wooseongjung/spyderrobot/assets/README.md

# assets/

Static media used by the README and docs.

| Folder | Contents |
|---|---|
| `images/` | Photos of the prototype, board renders, screenshots |
| `diagrams/` | System block diagrams, flowcharts (SVG / PNG) |
