wooseongjung/spyderrobot/firmware/README.md

# firmware/

Embedded C firmware for the custom MCU board.

| Folder | Contents |
|---|---|
| `mcu/` | STM32CubeIDE project: HAL, drivers, application |
| `tests/` | Host-side unit tests with mocked HAL |

Architecture: [`../docs/05-firmware-architecture.md`](../docs/05-firmware-architecture.md)
