wooseongjung/spyderrobot/hardware/enclosure/README.md

# hardware/enclosure/

3D-printed brackets and mounts for the custom PCB and sensors.

Source files: FreeCAD / SolidWorks. Export STLs for printing.

> Empty until the v1 PCB exists and we know what needs mounting.
