wooseongjung/spyderrobot/hardware/pcb/README.md

# hardware/pcb/

KiCad project for the custom STM32 MCU board.

> This folder will be populated in **Phase 3** (see [`../../docs/08-roadmap-milestones.md`](../../docs/08-roadmap-milestones.md)).

Expected layout once populated:

```
pcb/
├── spyder-mcu.kicad_pro
├── spyder-mcu.kicad_sch
├── spyder-mcu.kicad_pcb
├── symbols/                (custom symbol library)
├── footprints/             (custom footprint library)
├── 3d/                     (custom 3D models)
└── gerbers/                (export per fab order)
```

Spec: [`../../docs/04-pcb-design.md`](../../docs/04-pcb-design.md)
Bring-up checklist: [`../../docs/09-test-and-validation.md`](../../docs/09-test-and-validation.md)
