wooseongjung/spyderrobot/hardware/schematics/README.md

# hardware/schematics/

Block diagrams, schematic PDFs, and sub-circuit reference notes.

> Empty until Phase 3. Schematic source-of-truth is the KiCad project in `../pcb/`; this folder is for **exported** PDFs and **standalone block diagrams** that don't belong inside the KiCad project.
