wooseongjung/spyderrobot/assets/diagrams/README.md

# assets/diagrams/

System block diagrams, comms diagrams, power tree, etc.

Source format: prefer SVG (editable, version-controllable) over PNG.

> Empty until ASCII diagrams in `docs/02-system-architecture.md` are upgraded to proper SVGs.
