wooseongjung/spyderrobot/assets/images/README.md

# assets/images/

Photos of the physical prototype, board renders, and dashboard screenshots.

> Empty until Phase 1 produces the first photos.
