wooseongjung/spyderrobot/spider/meshes/ankle_LB_link.STL

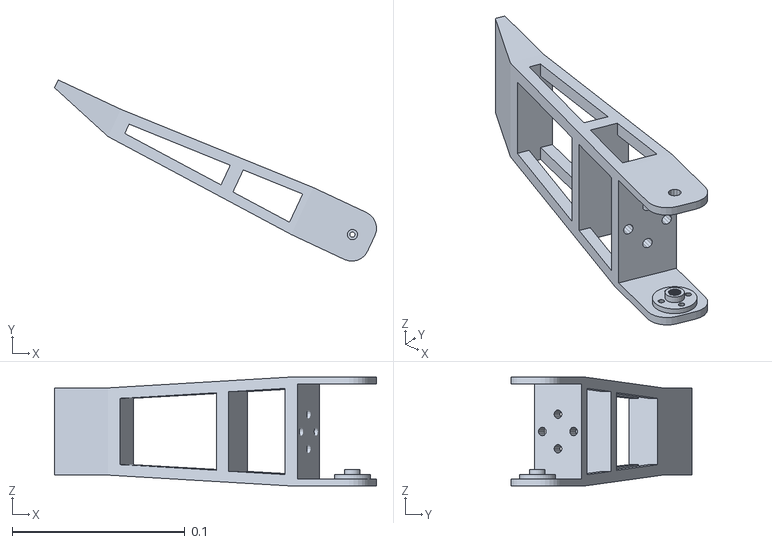
[picture p2: CAD file, 2025-08-24]
spider/meshes/ankle_LB_link.STL
0.186 x 0.105 x 0.063
