wooseongjung/spyderrobot/spider/meshes/knee_RF_link.STL

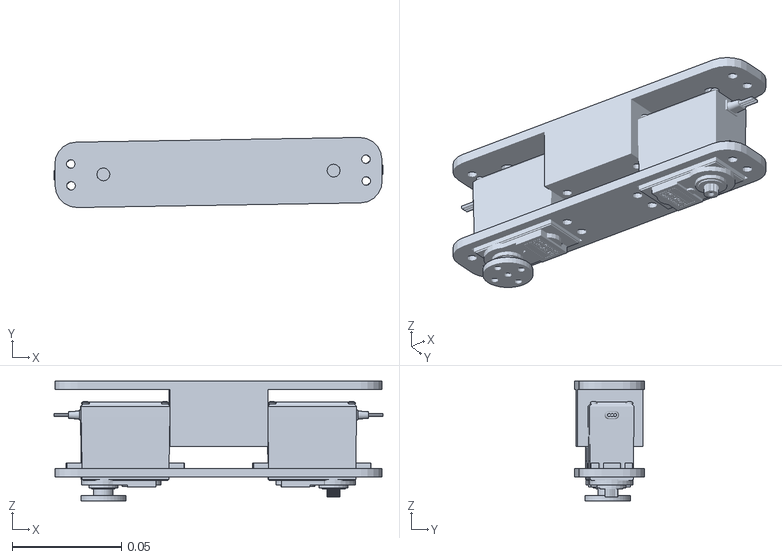
[picture p3: CAD file, 2025-08-24]
spider/meshes/knee_RF_link.STL
0.151 x 0.0321 x 0.055
