wooseongjung/spyderrobot/spider/meshes/hip_RF_link.STL

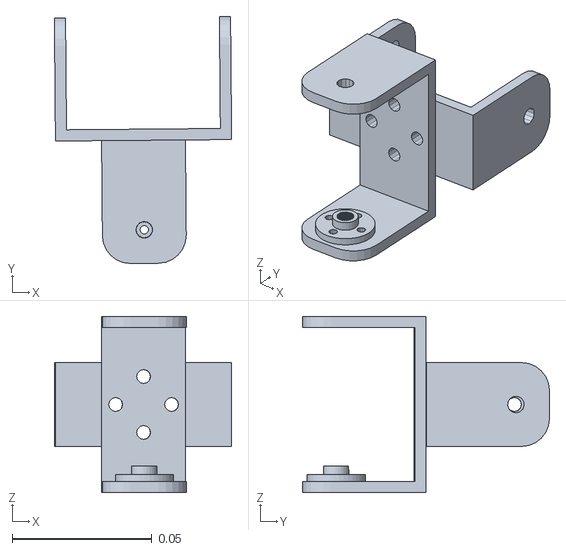
[picture p4: CAD file, 2025-08-24]
spider/meshes/hip_RF_link.STL
0.0634 x 0.0883 x 0.063
