wooseongjung/spyderrobot/spider/meshes/knee_LF_link.STL

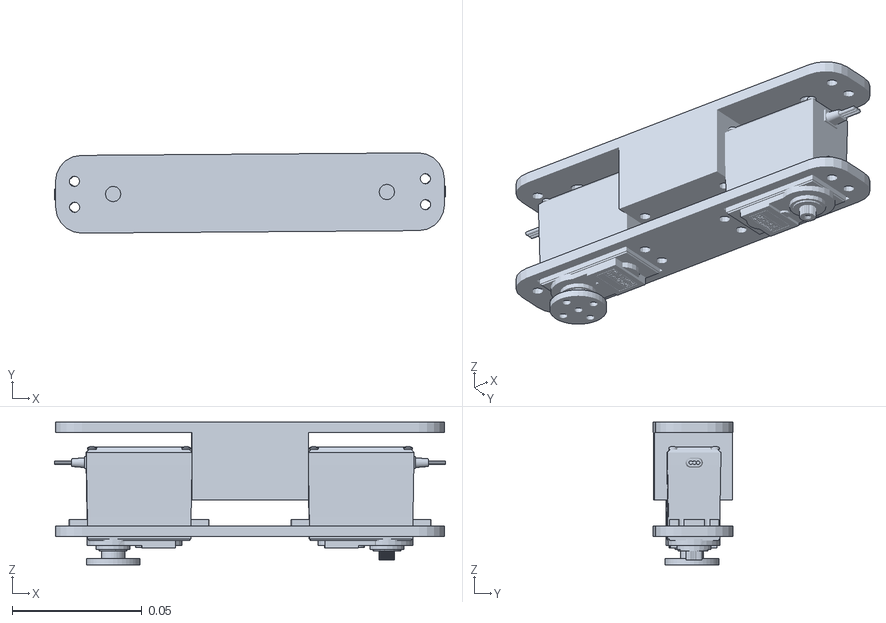
[picture p5: CAD file, 2025-08-24]
spider/meshes/knee_LF_link.STL
0.151 x 0.031 x 0.055
