wooseongjung/spyderrobot/spider/meshes/hip_LB_link.STL

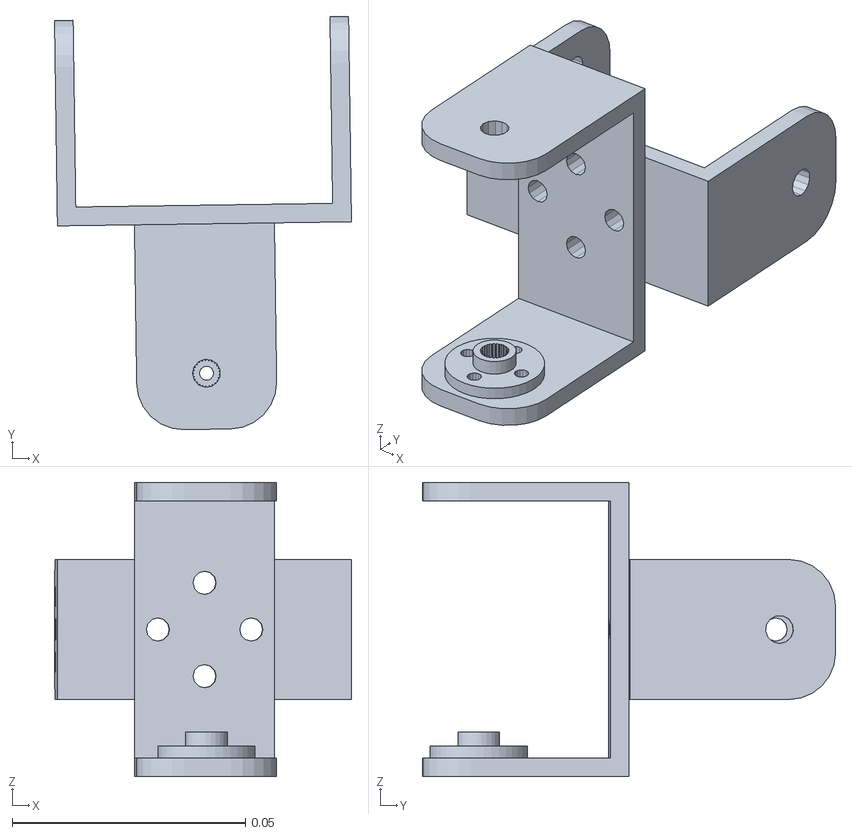
[picture p6: CAD file, 2025-08-24]
spider/meshes/hip_LB_link.STL
0.0636 x 0.0885 x 0.063
