wooseongjung/spyderrobot/spider/meshes/ankle_RB_link.STL

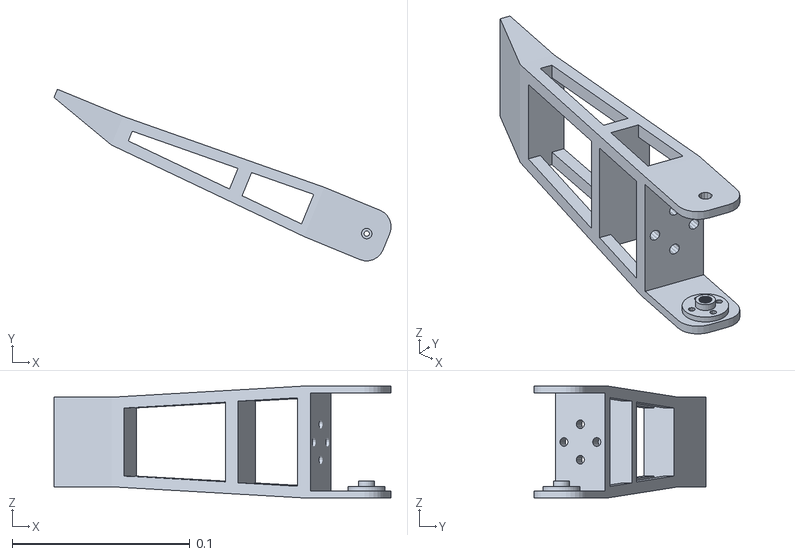
[picture p7: CAD file, 2025-08-24]
spider/meshes/ankle_RB_link.STL
0.19 x 0.0966 x 0.063
