wooseongjung/spyderrobot/spider/meshes/ankle_LF_link.STL

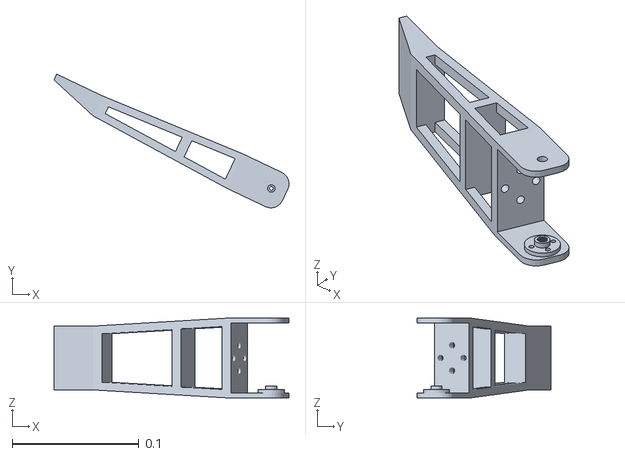
[picture p8: CAD file, 2025-08-24]
spider/meshes/ankle_LF_link.STL
0.186 x 0.106 x 0.063
