wooseongjung/spyderrobot/spider/meshes/base_link.STL

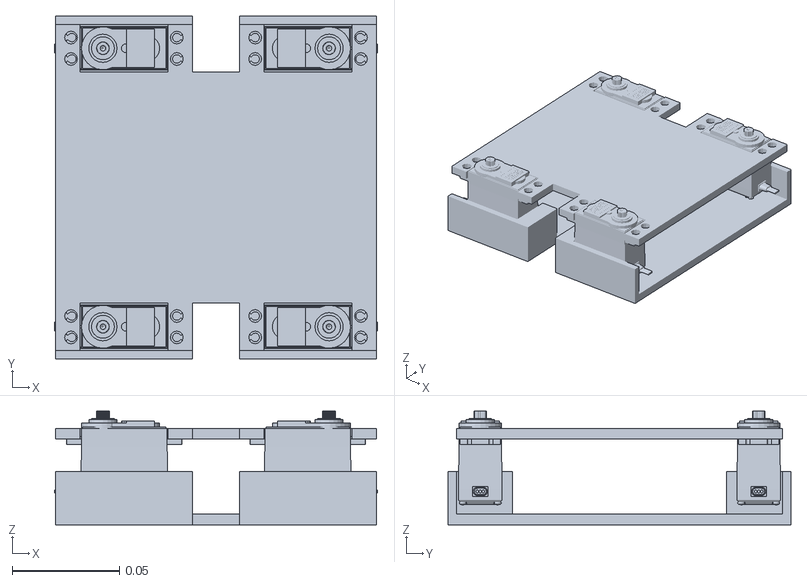
[picture p9: CAD file, 2025-08-24]
spider/meshes/base_link.STL
0.151 x 0.16 x 0.0531
