wooseongjung/spyderrobot/(list of files, cad)

Other CAD files:
spider/meshes/knee_RB_link.STL
spider/meshes/hip_RB_link.STL
spider/meshes/ankle_RF_link.STL
spider/meshes/hip_LF_link.STL
spider/meshes/knee_LB_link.STL
