wooseongjung/spyderrobot/hardware/pcb/spyder-mcu-v1/spyder-mcu-v1.kicad_sch

## KiCad design hardware/pcb/spyder-mcu-v1/spyder-mcu-v1.kicad_sch (2026-04-12)

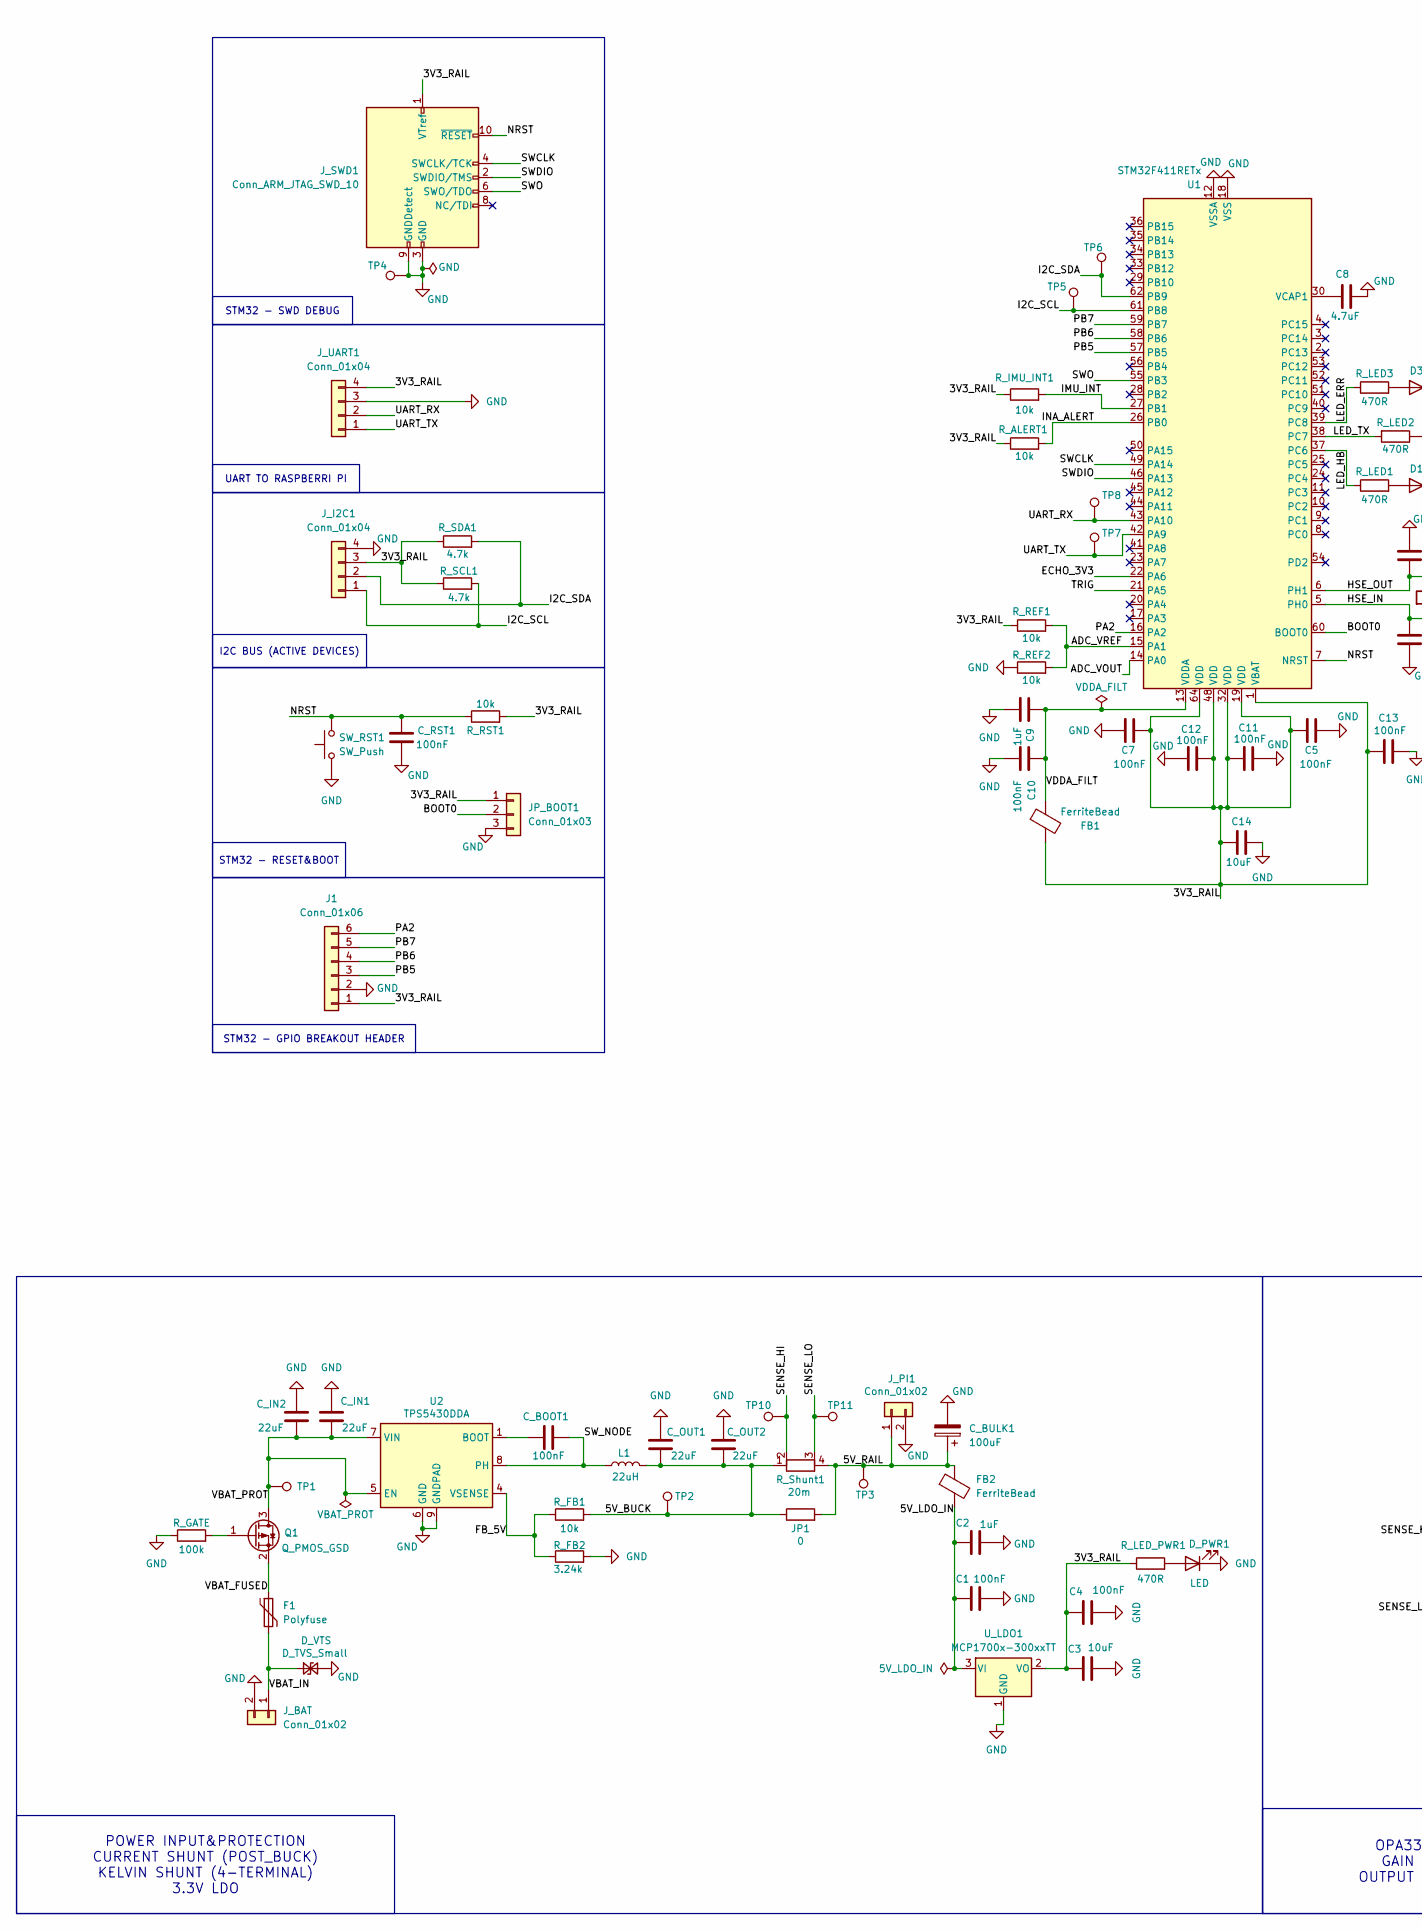
[picture p10: schematic spyder-mcu-v1.kicad_sch, part in row 1, column 1]

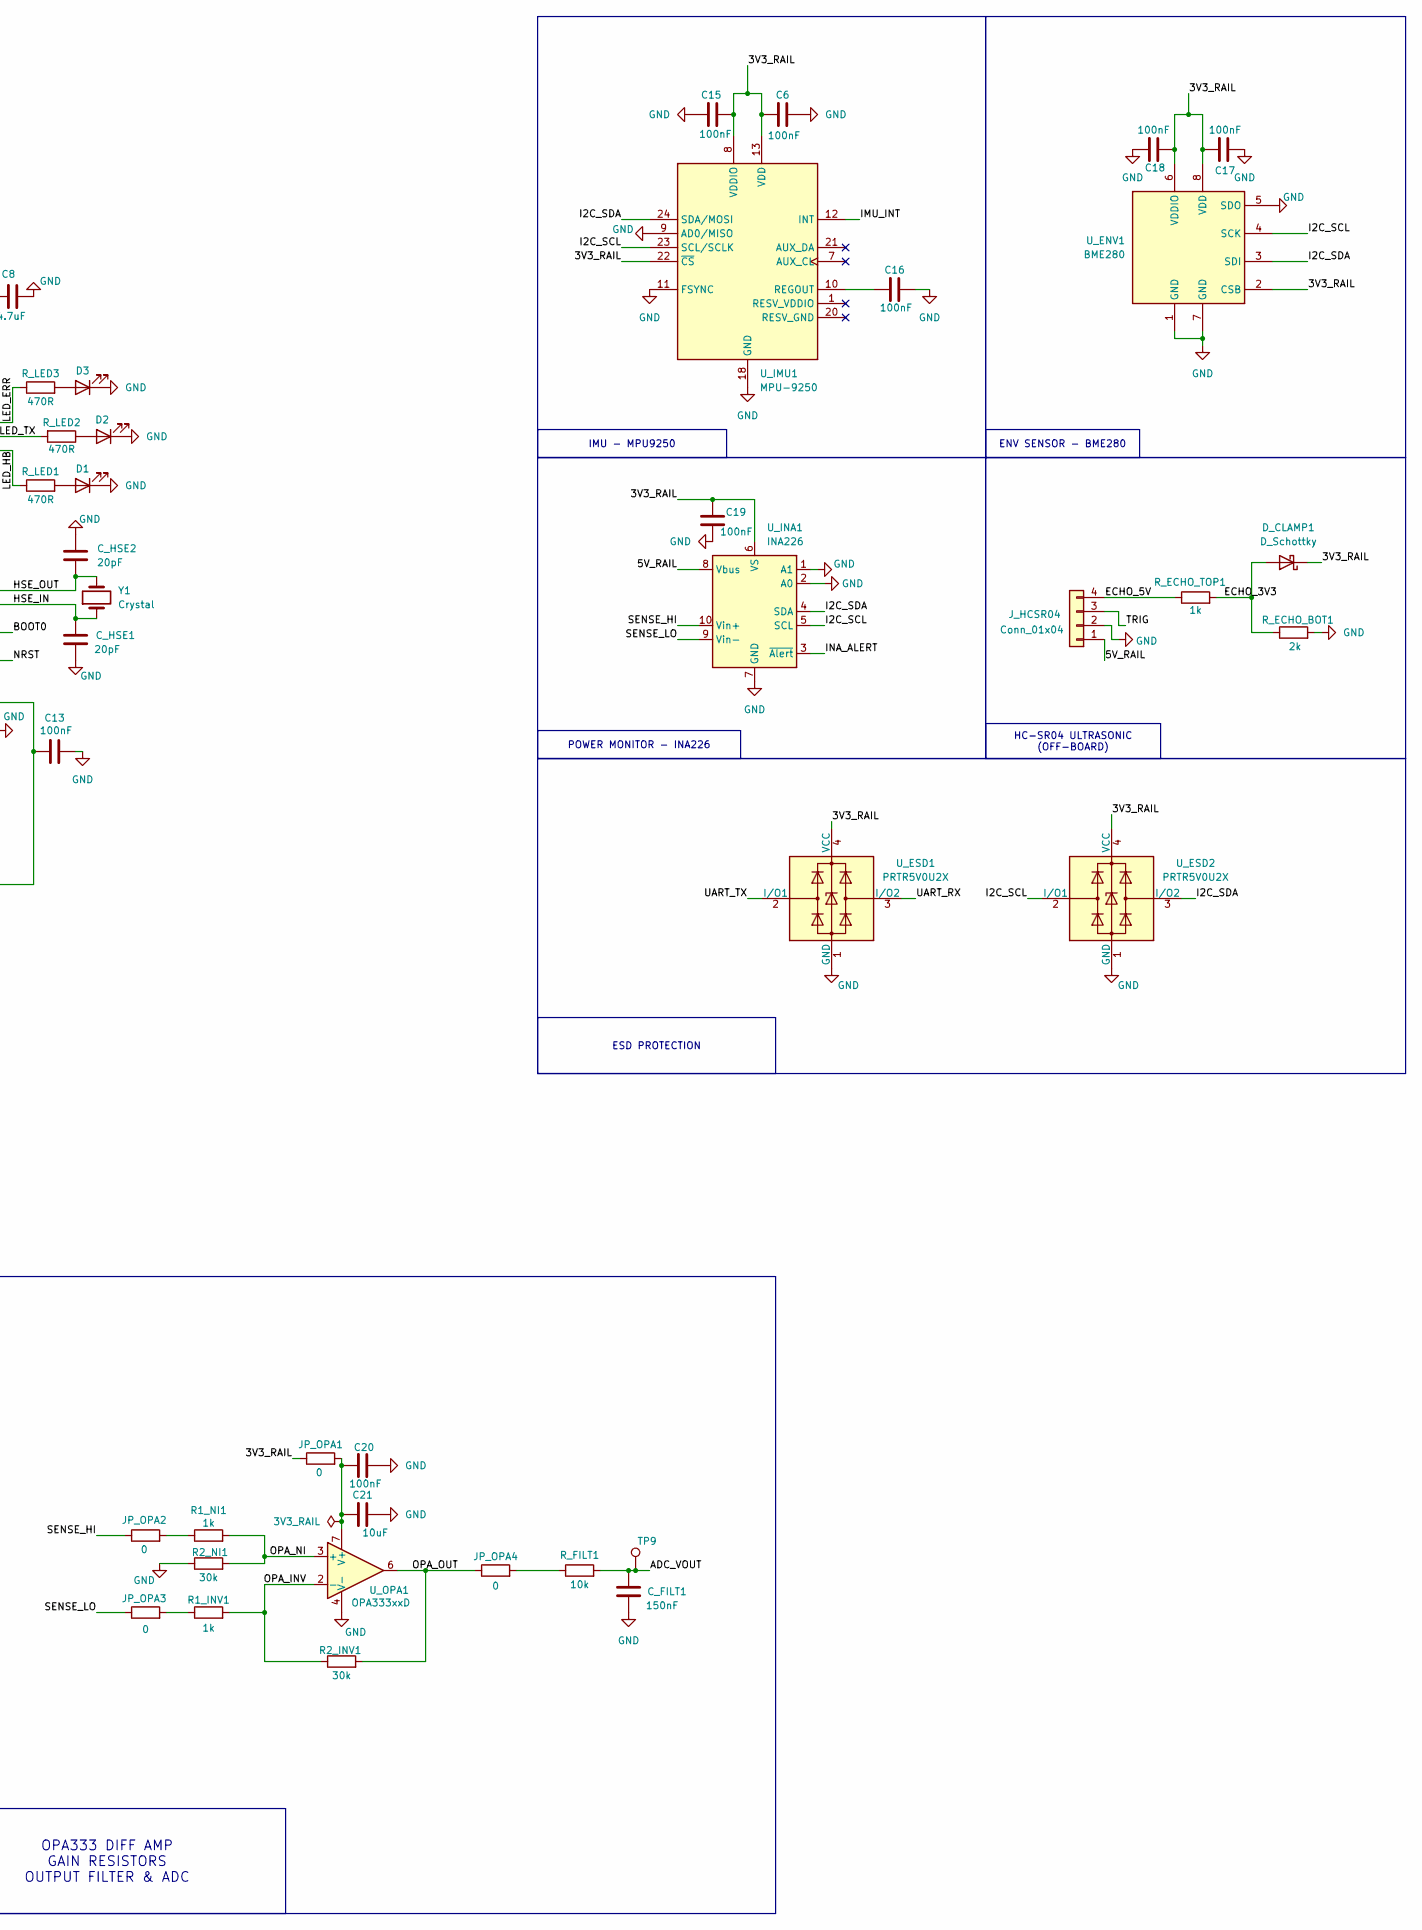
[picture p11: schematic spyder-mcu-v1.kicad_sch, part in row 1, column 2]

Parts:
C1, C4, C5, C6, C7, C10, C11, C12, C13, C15, C16, C17, C18, C19, C20: 100nF
C2, C9: 1uF
C3, C14, C21: 10uF
C8: 4.7uF
C_BOOT1: 100nF
C_BULK1: 100uF
C_FILT1: 150nF
C_HSE1, C_HSE2: 20pF; C_0805_2012Metric_Pad1.18x1.45mm_HandSolder
C_IN1, C_IN2: 22uF
C_OUT1, C_OUT2: 22uF
C_RST1: 100nF
D1, D2, D3: LED
D_CLAMP1: D_Schottky
D_PWR1: LED
D_VTS: D_TVS_Small
F1: Polyfuse
FB1, FB2: FerriteBead
J1: Conn_01x06
JP1: 0
JP_BOOT1: Conn_01x03
JP_OPA1, JP_OPA2, JP_OPA3, JP_OPA4: 0
J_BAT: Conn_01x02
J_HCSR04: Conn_01x04
J_I2C1: Conn_01x04
J_PI1: Conn_01x02
J_SWD1: Conn_ARM_JTAG_SWD_10
J_UART1: Conn_01x04
L1: 22uH
Q1: Q_PMOS_GSD
R1_INV1, R1_NI1: 1k
R2_INV1, R2_NI1: 30k
R_ALERT1: 10k
R_ECHO_BOT1: 2k
R_ECHO_TOP1: 1k
R_FB1: 10k
R_FB2: 3.24k
R_FILT1: 10k
R_GATE: 100k
R_IMU_INT1: 10k
R_LED1, R_LED2, R_LED3: 470R
R_LED_PWR1: 470R
R_REF1, R_REF2: 10k
R_RST1: 10k
R_SCL1: 4.7k
R_SDA1: 4.7k
R_Shunt1: 20m
SW_RST1: SW_Push
TP1, TP2, TP3, TP4, TP5, TP6, TP7, TP8, TP9, TP10, TP11: TestPoint
U1: STM32F411RETx; LQFP-64_10x10mm_P0.5mm
U2: TPS5430DDA; TI_SO-PowerPAD-8_ThermalVias
U_ENV1: BME280; Bosch_LGA-8_2.5x2.5mm_P0.65mm_ClockwisePinNumbering
U_ESD1, U_ESD2: PRTR5V0U2X; SOT-143
U_IMU1: MPU-9250; InvenSense_QFN-24_3x3mm_P0.4mm
U_INA1: INA226; TSSOP-10_3x3mm_P0.5mm
U_LDO1: MCP1700x-300xxTT; SOT-23
U_OPA1: OPA333xxD; SOIC-8_3.9x4.9mm_P1.27mm
Y1: Crystal; Crystal_SMD_HC49-SD_HandSoldering

Connections:
3V3_RAIL: C3.1, C4.1, C5.2, C6.1, C7.1, C11.2, C12.2, C13.1, C14.1, C15.2, C17.1, C18.2, C19.1, D_CLAMP1.1 (K), FB1.2, J1.1, JP_BOOT1.1, JP_OPA1.1, J_I2C1.3, J_SWD1.1 (VTref), J_UART1.4, R_ALERT1.1, R_IMU_INT1.1, R_LED_PWR1.1, R_REF1.1, R_RST1.2, R_SCL1.1, R_SDA1.1, U1.1 (VBAT), U1.19 (VDD), U1.32 (VDD), U1.48 (VDD), U1.64 (VDD), U_ENV1.2 (CSB), U_ENV1.6 (VDDIO), U_ENV1.8 (VDD), U_ESD1.4 (VCC), U_ESD2.4 (VCC), U_IMU1.8 (VDDIO), U_IMU1.13 (VDD), U_IMU1.22 (~CS), U_INA1.6 (VS), U_LDO1.2 (VO)
5V_BUCK: C_OUT1.2, C_OUT2.2, JP1.1, L1.2, R_FB1.2, R_Shunt1.1, TP2.1
5V_LDO_IN: C1.1, C2.1, FB2.2, U_LDO1.3 (VI)
5V_RAIL: C_BULK1.1, FB2.1, JP1.2, J_HCSR04.1, J_PI1.1, R_Shunt1.4, TP3.1, U_INA1.8 (Vbus)
ADC_VOUT: C_FILT1.1, R_FILT1.2, TP9.1, U1.14 (PA0)
ADC_VREF: R_REF1.2, R_REF2.2, U1.15 (PA1)
BOOT0: JP_BOOT1.2, U1.60 (BOOT0)
ECHO_3V3: D_CLAMP1.2 (A), R_ECHO_BOT1.1, R_ECHO_TOP1.2, U1.22 (PA6)
ECHO_5V: J_HCSR04.4, R_ECHO_TOP1.1
FB_5V: R_FB1.1, R_FB2.1, U2.4 (VSENSE)
GND: C1.2, C2.2, C3.2, C4.2, C5.1, C6.2, C7.2, C8.2, C9.2, C10.2, C11.1, C12.1, C13.2, C14.2, C15.1, C16.2, C17.2, C18.1, C19.2, C20.2, C21.2, C_BULK1.2, C_FILT1.2, C_HSE1.2, C_HSE2.1, C_IN1.1, C_IN2.1, C_OUT1.1, C_OUT2.1, C_RST1.2, D1.1 (K), D2.1 (K), D3.1 (K), D_PWR1.1 (K), D_VTS.2 (A2), J1.2, JP_BOOT1.3, J_BAT.2, J_HCSR04.2, J_I2C1.4, J_PI1.2, J_SWD1.3 (GND), J_SWD1.5 (GND), J_SWD1.9 (GNDDetect), J_UART1.3, R2_NI1.1, R_ECHO_BOT1.2, R_FB2.2, R_GATE.1, R_REF2.1, SW_RST1.1, TP4.1, U1.12 (VSSA), U1.18 (VSS), U1.31 (VSS), U1.47 (VSS), U1.63 (VSS), U2.6 (GND), U2.9 (GNDPAD), U_ENV1.1 (GND), U_ENV1.5 (SDO), U_ENV1.7 (GND), U_ESD1.1 (GND), U_ESD2.1 (GND), U_IMU1.9 (AD0/MISO), U_IMU1.11 (FSYNC), U_IMU1.18 (GND), U_INA1.1 (A1), U_INA1.2 (A0), U_INA1.7 (GND), U_LDO1.1 (GND), U_OPA1.4 (V-)
HSE_IN: C_HSE1.1, U1.5 (PH0), Y1.1
HSE_OUT: C_HSE2.2, U1.6 (PH1), Y1.2
I2C_SCL: J_I2C1.1, R_SCL1.2, TP5.1, U1.61 (PB8), U_ENV1.4 (SCK), U_ESD2.2 (I/O1), U_IMU1.23 (SCL/SCLK), U_INA1.5 (SCL)
I2C_SDA: J_I2C1.2, R_SDA1.2, TP6.1, U1.62 (PB9), U_ENV1.3 (SDI), U_ESD2.3 (I/O2), U_IMU1.24 (SDA/MOSI), U_INA1.4 (SDA)
IMU_INT: R_IMU_INT1.2, U1.27 (PB1), U_IMU1.12 (INT)
INA_ALERT: R_ALERT1.2, U1.26 (PB0), U_INA1.3 (~Alert)
LED_ERR: R_LED3.1, U1.39 (PC8)
LED_HB: R_LED1.1, U1.37 (PC6)
LED_TX: R_LED2.2, U1.38 (PC7)
NRST: C_RST1.1, J_SWD1.10 (~RESET), R_RST1.1, SW_RST1.2, U1.7 (NRST)
unnamed: C8.1, U1.30 (VCAP1)
unnamed: C16.1, U_IMU1.10 (REGOUT)
unnamed: C20.1, C21.1, JP_OPA1.2, U_OPA1.7 (V+)
unnamed: C_BOOT1.1, U2.1 (BOOT)
unnamed: D1.2 (A), R_LED1.2
unnamed: D2.2 (A), R_LED2.1
unnamed: D3.2 (A), R_LED3.2
unnamed: D_PWR1.2 (A), R_LED_PWR1.2
unnamed: JP_OPA2.2, R1_NI1.1
unnamed: JP_OPA3.2, R1_INV1.1
unnamed: JP_OPA4.2, R_FILT1.1
unnamed: Q1.1 (G), R_GATE.2
OPA_INV: R1_INV1.2, R2_INV1.1, U_OPA1.2 (-)
OPA_NI: R1_NI1.2, R2_NI1.2, U_OPA1.3 (+)
OPA_OUT: JP_OPA4.1, R2_INV1.2, U_OPA1.6
PA2: J1.6, U1.16 (PA2)
PB5: J1.3, U1.57 (PB5)
PB6: J1.4, U1.58 (PB6)
PB7: J1.5, U1.59 (PB7)
SENSE_HI: JP_OPA2.1, R_Shunt1.2, TP10.1, U_INA1.10 (Vin+)
SENSE_LO: JP_OPA3.1, R_Shunt1.3, TP11.1, U_INA1.9 (Vin-)
SWCLK: J_SWD1.4 (SWCLK/TCK), U1.49 (PA14)
SWDIO: J_SWD1.2 (SWDIO/TMS), U1.46 (PA13)
SWO: J_SWD1.6 (SWO/TDO), U1.55 (PB3)
SW_NODE: C_BOOT1.2, L1.1, U2.8 (PH)
TRIG: J_HCSR04.3, U1.21 (PA5)
UART_RX: J_UART1.2, TP8.1, U1.43 (PA10), U_ESD1.3 (I/O2)
UART_TX: J_UART1.1, TP7.1, U1.42 (PA9), U_ESD1.2 (I/O1)
VBAT_FUSED: F1.1, Q1.2 (S)
VBAT_IN: D_VTS.1 (A1), F1.2, J_BAT.1
VBAT_PROT: C_IN1.2, C_IN2.2, Q1.3 (D), TP1.1, U2.5 (EN), U2.7 (VIN)
VDDA_FILT: C9.1, C10.1, FB1.1, U1.13 (VDDA)

Notes on the sheet:
HC-SR04 ULTRASONIC (OFF-BOARD)
OPA333 DIFF AMP GAIN RESISTORS OUTPUT FILTER & ADC
STM32 - SWD DEBUG
ENV SENSOR - BME280
UART TO RASPBERRI PI
STM32 - RESET&BOOT
I2C BUS (ACTIVE DEVICES)
POWER MONITOR - INA226
IMU - MPU9250
ESD PROTECTION
POWER INPUT&PROTECTION CURRENT SHUNT (POST_BUCK) KELVIN SHUNT (4-TERMINAL) 3.3V LDO
STM32 - GPIO BREAKOUT HEADER
