wooseongjung/spyderrobot/pi/telemetry/logger.py

"""Phase 1 telemetry logger.

Polls every sensor at the rate set in config.yaml, writes one CSV row
per cycle, prints a one-line status to stdout, and (optionally) updates
the OLED display.

Run on the Pi:
    cd ~/spyderrobot/pi/telemetry
    python -m logger

Stop with Ctrl-C; the CSV file is closed cleanly.
"""

from __future__ import annotations

import csv
import signal
import sys
import time
from dataclasses import asdict
from datetime import datetime, timezone
from pathlib import Path

import yaml

from display import OledDisplay
from sensors.dht11 import DHT11
from sensors.hcsr04 import HCSR04
from sensors.mpu6050 import MPU6050


CONFIG_PATH = Path(__file__).parent / "config.yaml"


def load_config() -> dict:
    with open(CONFIG_PATH) as f:
        return yaml.safe_load(f)


def open_csv(path: Path) -> tuple:
    """Open the output CSV and write the header row."""
    path.parent.mkdir(parents=True, exist_ok=True)
    f = open(path, "w", newline="")
    writer = csv.writer(f)
    writer.writerow([
        "iso_ts", "t_ms",
        "ax_g", "ay_g", "az_g",
        "gx_dps", "gy_dps", "gz_dps",
        "imu_temp_c",
        "env_temp_c", "env_rh",
        "dist_mm",
        "errors_imu", "errors_env", "errors_dist",
    ])
    return f, writer


def main() -> int:
    cfg = load_config()
    period_s = 1.0 / cfg.get("rate_hz", 5)
    out_path = Path(cfg.get("output_csv", "sample_data/run.csv"))
    sensor_cfg = cfg.get("sensors", {})

    imu  = MPU6050()  if sensor_cfg.get("imu",      {}).get("enabled", True) else None
    env  = DHT11()    if sensor_cfg.get("env",      {}).get("enabled", True) else None
    dist = HCSR04()   if sensor_cfg.get("distance", {}).get("enabled", True) else None

    display_cfg = cfg.get("display", {})
    display = (
        OledDisplay(address=int(display_cfg.get("i2c_address", 0x3C)))
        if display_cfg.get("enabled", False)
        else None
    )

    for s in (imu, env, dist, display):
        if s is None:
            continue
        try:
            s.open()
        except NotImplementedError as e:
            print(f"[skip] {type(s).__name__}: {e}", file=sys.stderr)

    t0 = time.monotonic()
    f, writer = open_csv(out_path)

    stopping = False
    def _stop(_signum, _frame):
        nonlocal stopping
        stopping = True
    signal.signal(signal.SIGINT, _stop)
    signal.signal(signal.SIGTERM, _stop)

    try:
        while not stopping:
            cycle_start = time.monotonic()
            t_ms = int((cycle_start - t0) * 1000)
            iso_ts = datetime.now(timezone.utc).isoformat(timespec="milliseconds")

            imu_r  = _safe_read(imu)  if imu  else None
            env_r  = _safe_read(env)  if env  else None
            dist_r = _safe_read(dist) if dist else None

            row = [
                iso_ts, t_ms,
                *(imu_r.accel_g if imu_r else (None, None, None)),
                *(imu_r.gyro_dps if imu_r else (None, None, None)),
                imu_r.temp_c if imu_r else None,
                env_r.temp_c if env_r else None,
                env_r.rh if env_r else None,
                dist_r.distance_mm if dist_r else None,
                imu.error_count  if imu  else 0,
                env.error_count  if env  else 0,
                dist.error_count if dist else 0,
            ]
            writer.writerow(row)
            f.flush()

            print(f"[{iso_ts}] env={row[9]}C/{row[10]}% ax={row[2]} ay={row[3]} az={row[4]}")

            if display is not None:
                try:
                    display.show({
                        "ax": row[2], "ay": row[3], "az": row[4],
                        "temp_c": row[9], "rh": row[10],
                    })
                except Exception as e:
                    print(f"[display] {e}", file=sys.stderr)

            sleep_s = period_s - (time.monotonic() - cycle_start)
            if sleep_s > 0:
                time.sleep(sleep_s)
    finally:
        f.close()
        for s in (imu, env, dist, display):
            if s is None:
                continue
            try:
                s.close()
            except Exception:
                pass

    return 0


def _safe_read(sensor):
    """Call .read() and swallow NotImplementedError so the logger can run
    even when only some drivers are wired up. Real exceptions still pass
    through."""
    try:
        return sensor.read()
    except NotImplementedError:
        return None


if __name__ == "__main__":
    raise SystemExit(main())
