wooseongjung/spyderrobot/(commit log)

2025-08-22 spyderURDF
    prototype version of spyder robot is designed through Solidworks and exported in URDF file with meshes
    [ankle_LB_link.STL, ankle_LF_link.STL, ankle_RB_link.STL, ankle_RF_link.STL, base_link.STL, hip_LB_link.STL, hip_LF_link.STL, hip_RB_link.STL]
2025-08-24 Updated version of URDF for spyder robot
    Added motors, and bottom plate as an entity since when simulated the previous URDF to SDF converted file, it collapsed immediately as I start simulating. I thought this might be because of not fully defining the object which led to having spaces between parts and immediately collapse.
    [ankle_LB_link.STL, ankle_LF_link.STL, ankle_RB_link.STL, ankle_RF_link.STL, base_link.STL, hip_LB_link.STL, hip_LF_link.STL, hip_RB_link.STL]
2026-04-09 chore: add MIT LICENSE and .gitignore
    Adds an MIT license and a .gitignore covering KiCad, STM32CubeIDE,
    PlatformIO, Python, and ROS build artefacts. Preserves spider/export.log
    since it ships with the existing ROS package.
2026-04-09 docs: rewrite README to frame project as sensing platform
    Reframes spyderrobot from "12-servo quadruped that performs spider
    motion" to "sensorised quadruped platform for remote environmental
    awareness and robot-state monitoring." The original 1-line description
    is preserved verbatim as a blockquote near the top.
    The new README adds:
    - project status table tied to phased milestones
    - Option A system architecture diagram (Pi 5 + custom MCU board +
    external PCA9685)
    - repo layout pointing at the new docs/ and scaffold folders
    - skills demonstrated section aimed at recruiters
    - prototype vs target-v2 hardware table
    - index of all docs/01..12 files
    The existing spider/ ROS package is referen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
2026-04-09 docs: add docs/ folder with engineering documentation outlines
    Adds 12 documentation files as structured outlines with TODO markers
    for technical details that will be filled in as the project progresses.
    01-project-overview.md problem statement, scope, what it is NOT
    02-system-architecture.md block diagram, comms, power tree
    03-hardware-bom.md prototype vs target-v2 BOM
    04-pcb-design.md custom STM32 board spec, functional blocks
    05-firmware-architecture.md STM32 layered design, scheduler, UART frame
    06-pi-software.md Pi 5 telemetry, dashboard, camera, UI
    07-mechanical-simulation.md cross-references the existing spider/ ROS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
2026-04-09 chore: add scaffold folders for hardware, firmware, pi, assets
    Adds empty scaffold folders so future commits in each phase land in
    the right place. Each folder ships with a small README explaining what
    belongs there and which phase will populate it.
    hardware/pcb/ KiCad project (Phase 3)
    hardware/schematics/ exported schematic PDFs and standalone block diagrams
    hardware/enclosure/ 3D-printed mounts (post-PCB)
    firmware/mcu/ STM32CubeIDE project (Phase 2)
    firmware/tests/ host-side unit tests
    pi/telemetry/ UART parser, CSV logger, dashboard (Phases 1-2)
    pi/camera/ Pi AI Camera capture (Phase 5)
    pi/interface/ operator UI, joysti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
2026-04-09 feat(pi): scaffold Phase 1 telemetry stack on Pi 5
    Adds runnable Python skeletons for the Phase 1 breadboard prototype:
    read every prototype sensor directly from the Pi 5, log to CSV, and
    (optionally) push to the OLED. Phase 2 will replace the per-sensor
    reads with a UART parser for the custom MCU board, but the Phase 1
    loop is what proves each sensor works.
    pi/telemetry/sensors/mpu6050.py I2C IMU driver skeleton
    pi/telemetry/sensors/dht11.py 1-wire temp/humidity skeleton
    pi/telemetry/sensors/hcsr04.py ultrasonic distance skeleton
    pi/telemetry/sensors/raindrop.py digital wetness skeleton
    pi/telemetry/display.py SSD1306 OLED skeleton
    pi/telemetry/logger.py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
    [config.yaml, dht11.py, display.py, hcsr04.py, logger.py, mpu6050.py]
2026-04-09 docs(phase1): add wiring cheat sheet, narrow scope to IMU + DHT11 + OLED
    Phase 1 is now MPU6050 + DHT11 + SSD1306 OLED only. The HC-SR04 and
    raindrop sensors are deferred to Phase 2 (STM32), where the level
    shifting and analog ADC concerns are handled natively. Their driver
    scaffolds in pi/telemetry/sensors/ are kept but disabled in config.yaml.
    docs/phase1-wiring.md new: step-by-step wiring cheat sheet
    with Pi 5 pin map, i2cdetect verification,
    3-pin vs 4-pin DHT11 variants, sanity
    checks before power-on, troubleshooting
    table, and first-light test seque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
2026-04-09 docs(phase1): add NI myDAQ sidebar to wiring cheat sheet
    Adds a section on using the NI myDAQ as the bench instrument during
    Phase 1 bring-up, covering:
    - DMM continuity + rail checks before powering anything
    - Scope probing SDA/SCL when i2cdetect fails or shows ghost addresses,
    with a short diagnosis table for the common waveforms (no activity,
    stuck line, slow edges, garbled)
    - Using the myDAQ +5 V supply to bench-test a sensor module without
    risking the Pi
    No scope change to Phase 1 - the two deferred sensors stay deferred.
2026-04-09 docs: add CLAUDE.md for cross-session project instructions
    Bootstraps every Claude Code session opening this repo with:
    - the project's re-scoped framing (sensor platform, not just a quadruped)
    - the three mandatory reads at session start (vision, roadmap, fault log)
    - standing rules (preserve spider/, append to fault log, respect phases)
    - where every concern lives in the repo tree
    - the user's bench hardware (NI myDAQ) so debug suggestions are grounded
    This is the mechanism for sharing docs/11-fault-record.md and
    docs/12-ultimate-vision.md across sessions: the repo files already exist,
    CLAUDE.md is what makes future Claude sessions actually read them.
2026-04-09 feat(pi): implement MPU6050 and DHT11 drivers for Phase 1 first light
    Wires up the two Phase 1 on-Pi sensors so the telemetry logger
    emits real readings instead of the None placeholders left by the
    scaffold drivers.
    - MPU6050: open() opens SMBus(1) and clears PWR_MGMT_1 to wake the
    device; read() pulls the 14-byte block from ACCEL_XOUT_H in one
    bus transaction and decodes accel, temperature and gyro via the
    existing _to_int16 helper and ACCEL_SCALE/GYRO_SCALE constants.
    OSError bumps error_count and returns None so the logger keeps
    cycling.
    - DHT11: open() builds an adafruit_dht.DHT11 on board.D<pin> via
    Blinka; read() swallows RuntimeError and missing fields so the
    logger abs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
    [run.csv]
2026-04-09 feat(pi): drive SSD1306 OLED from the telemetry logger
    Implements the OLED scaffold and wires it into the logger loop so
    each cycle pushes the latest IMU + DHT11 reading to the 0.96" OLED
    that shares I2C1 with the MPU6050.
    - display.py: open() now builds a real adafruit_ssd1306.SSD1306_I2C
    on busio.I2C(board.SCL, board.SDA), clears the panel, and caches
    the PIL default font. show() renders four lines — ax/ay/az in g,
    and a single line with DHT11 temperature + humidity — laid out
    for a 128x64 panel, with '--' placeholders for None fields so a
    missed DHT11 checksum doesn't blank the screen.
    - logger.py: constructs OledDisplay when display.enabled is true in
    config.yaml, open()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
    [display.py, logger.py]
2026-04-09 fix(pi): correct env temp/humidity column indices in logger
    The CSV row layout is row[9]=env_temp_c, row[10]=env_rh,
    row[11]=dist_mm, but both the debug print and the OLED show()
    call were reading row[10]/row[11] — displaying humidity as
    temperature and (disabled) distance as humidity. The OLED was
    showing "T 59.0C H --%" for a room at 24 C / 62 %RH.
    Fix the indices; the stdout line now also tags the units
    (e.g. env=24.6C/62%).
    [logger.py]
2026-04-09 docs(fault-record): log the OLED temp/humidity column-index off-by-one
    Per the standing rule in CLAUDE.md, append a fault-record entry for
    any non-trivial debug session. This one is the classic "silly"
    off-by-one that the log is meant to capture — and the lesson (don't
    trust existing debug prints as an oracle) is worth keeping.
2026-04-09 docs(phase1): close out Phase 1 with rig photo and endurance waiver
    Phase 1 exit criterion now fully green:
    - MPU6050 + DHT11 drivers return plausible values (gravity magnitude
    within 1% of 1g, env readings match a room thermometer)
    - CSV log committed under pi/telemetry/sample_data/run.csv
    - OLED displays live IMU + env temp/humidity via pi/telemetry/display.py
    - Photo of breadboard rig added: assets/images/phase1-breadboard.jpg
    (Pi 5 + MPU6050 + DHT11 + SSD1306 showing "spyderrobot P1" with
    live accelerometer + environment readings from the logger)
    - Fault record entry already landed (PR #5): OLED column off-by-one
    The "30 min uninterrupted" criterion is waived; rationale logged as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
2026-04-10 chore(scope): remove raindrop, lock MPU9250 as v1 IMU (ADR-0006, ADR-0007)
    Tighten project scope: the raindrop sensor was carried over from the
    original sensor kit but never earned its place in the
    sensing-platform framing. Remove it from the BOM, PCB spec, firmware
    scaffold, Pi telemetry code, and wiring doc. ADR-0006 explains why.
    Separately, commit to MPU9250 as the v1 end-product IMU and demote
    MPU6050 to Phase 1 prototype status. The docs and PCB sensor block
    were treating the two as interchangeable placeholders, but "IMU-
    agnostic" is a fiction once firmware actually has to drive the
    AK8963 magnetometer passthrough. ADR-0007 records the commitment.
    Changes:
    - Delete pi/telemetry/sens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
    [config.yaml, display.py, logger.py, mpu6050.py, mpu9250.py]
2026-04-10 docs(adr-0008): add discrete current-sense amp as v1 PCB analog showcase
    The v1 PCB now carries a discrete op-amp current-sense block in
    parallel with the INA226 on the same rail. INA226 is the production
    monitoring path; the discrete block is a deliberate analog-design
    showcase that proves I can reason about CMRR, matched-resistor
    tolerance, Kelvin-sense layout, and bandwidth — not just drop in an
    I²C chip.
    ADR-0008 records the policy and rationale: one well-chosen discrete
    block, on the same board as a named commercial reference part, is
    the maximum-signal / minimum-risk path to a credible analog-design
    artefact in the project's target job pipeline (ADI / Qualcomm
    analog / GE Vernova p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
2026-04-10 docs(pcb-prep): lock v1 part picks, power path, and pin budget (ADR-0009..0013)
    Five new ADRs unblock Phase 3 schematic capture in parallel with the
    NUCLEO-F411RE shipment, while leaving PCB layout strictly gated on
    Phase 2 firmware bring-up.
    ADRs:
    - ADR-0009: STM32F411RET6 (LQFP-64) on the v1 PCB, identical die to
    the Nucleo so Phase 2 firmware ports 1:1 in Phase 4.
    - ADR-0010: OPA333AIDBVR for the analog showcase (DC accuracy wins
    the trade at 10 Hz; OPA350/TLV9062 rejected on offset). Fallback
    OPA2333.
    - ADR-0011: INA226 and OPA333 block share a single Kelvin shunt so
    the residual is apples-to-apples by physics, not by part matching.
    - ADR-0012: 4-layer SIG/GND/PWR/SIG at JLCPCB.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
2026-04-10 docs(adr): refine analog showcase op-amp package and shunt part (ADR-0014, ADR-0015)
    Two schematic-time refinements discovered during KiCad capture of the analog
    showcase block.
    ADR-0014: OPA333 package deviates from SOT-23-5 (ADR-0010) to SOIC-8
    (OPA333AID). Same die, identical electricals; the SOIC-8 is materially easier
    to hand-solder and to scope-probe during the ADR-0008 bench validation sweep,
    which is where the portfolio signal actually comes from.
    ADR-0015: Shunt upgraded from 2-terminal WSL2512R0200FEA to 4-terminal Kelvin
    WSLP2512R0200FE. Kelvin commitment now lives in the part geometry instead of
    the layout, making it visible at the schematic, BOM, and footprint levels —
    the l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
2026-04-10 fix(adr-0015): correct shunt family WSLP → WSK (4-terminal Kelvin)
    WSLP2512 is a 2-terminal high-power part (max 10 mΩ) — NOT 4-terminal
    Kelvin. The "typical sensing traces" in the WSLP datasheet are PCB layout
    recommendations, not separate pads on the component.
    The correct Vishay 4-terminal Kelvin family is **WSK2512**:
    - Part: WSK2512R0200FEA (20 mΩ, 1%, 1W, 4-terminal)
    - Resistance range: 0.0005–0.2 Ω (20 mΩ well within range)
    - Terminal T = 1.19 mm for the 5–200 mΩ band
    - Current pads (I1, I2) and sense pads (E1, E2) on opposite diagonal
    corners — confirmed by Vishay datasheet doc 30108
    Best part: KiCad already ships with both the symbol and footprint:
    - Symbol: Devic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
2026-04-12 feat(pcb): add spyder-mcu-v1 schematic, wiring CSV, netlist, and footprint guide
    Complete KiCad schematic with all 103 components wired and verified:
    - TPS5430DDA on-board buck (7.4-12V → 5V), feedback divider fixed to
    3.24k (VREF=1.221V, not 0.8V — critical fix from design review)
    - Full protection chain: TVS (SMBJ12CA), PTC fuse, reverse-polarity
    FET (SiA457DJ) with 100k gate damping resistor
    - Kelvin 4-terminal shunt (WSK2512) with INA226 + OPA333 diff amp
    analog showcase, including JP_OPA4 output isolation jumper
    - SWO debug trace wired (PB3 → SWD pin 6)
    - All pin cross-reference typos corrected (C_BOOT, L1, R_FB VSENSE)
    - Footprint assignment guide for KiCad bulk assignment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
    [spyder-mcu-v1-symbols.csv, spyder-mcu-v1-wiring.csv, spyder-mcu-v1.kicad_pcb, spyder-mcu-v1.kicad_sch]
